stummk/Birdy-Cam/(commit log)

2026-08-10 Add BirdyCam project: docs, firmware & Pi software
    Add the complete BirdyCam project: user docs and full code for both variants. Includes README and detailed docs (01–09), ESP32 firmware (birdycam firmware modules, steps sketches, audio/avi/movement/lighting/network/etc.), Raspberry Pi software (Python service, web UI, ringspeicher, statistik, install script and systemd service), and supporting assets (templates). Implements camera, IR lighting, light‑barrier counting, SD ring buffers, power/INA219 handling, MJPEG/streaming, and audio capture. This is the initial project import with tutorials and install instructions.
2026-08-11 Add audio (clip+stream) and daily CSV archive
    Enable onboard microphone, add audio ring buffer, and include audio in clips and live stream. Rework audio subsystem (ring buffer, voice detection, WAV saving), extend AVI writer to interleave PCM audio, and add web audio endpoint (port 82) and UI controls. Implement hourly/dayly /tage.csv archive with fixed-length lines and /api/tage JSON export; persist daily stats and integrate into storage. Docs updated (hardware, panel guidance, build steps). Other changes: PWM raised to 20 kHz to avoid audio artifacts, power-panel warnings refined, config flags for AUDIO/TAGE options, and multiple firmware integrations (web, avi, audio, speicher, birdycam).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
    [audio.cpp, audio.h, avi.cpp, avi.h, birdycam.ino, config.h, lichtschranke.cpp, speicher.cpp]
2026-09-14 Define built-in LED and improve WiFi setup
    step1: add LED_BUILTIN definition (pin 21) for the board. step3: replace WLAN placeholders with "CHANGEME" and enhance WiFi initialization—perform WiFi.disconnect, set STA mode, lower min security to WPA2 (allows WPA3/WPA2 mixed hotspots), set TX power for XIAO S3, and provide clearer connection status prints. These changes improve portability and reliability when connecting the camera to modern hotspots.
    [step1_hallo.ino, step3_kamera.ino]
2026-09-20 Add audio amplification and sensor debouncing
    Implement audio signal amplification in step6_mikrofon for improved SD card recording and real-time bar display visualization. Add software debouncing in step7_lichtschranke to reduce sensor flickering issues. Include documentation images for settings configuration.
    [step6_mikrofon.ino, step7_lichtschranke.ino]
2026-09-21 Docs: correct MOSFET wiring for the opto-isolated HW-532 module
    Docs: the guide described a 3+4-terminal XY-MOS board, but the part that is
    actually sold is the 23x17 mm HW-532 (AOD4184 + PC817) with 2+3
    terminals: no OUT+, low-side switching, a shared + terminal, a 5 V
    gate-bias caveat and four GND wires instead of three
    Changed: IR dimming runs at 1 kHz instead of 20 kHz, which the PC817
    optocoupler cannot follow
    New: IR_PWM_FREQUENZ in config.h, plus a module self-test with diagnosis
    output in step4_irlicht
    [config.h, step4_irlicht.ino, strom.cpp]
2026-09-21 Docs: replace the JST-PH 2.0 Y-cable with two pigtails and a multimeter test
    JST-PH 2.0 splitters are essentially unobtainable — what is sold as a
    "JST Y-cable" in the RC world is the thicker RCY/BEC connector and does
    not fit the charger's BAT socket. Use two pigtails instead and let the
    sensor's screw terminal act as the junction; both wires per pole go into
    the same clamp.
    Section 3.8 now also answers whether the sensor is needed at all: the
    Waveshare charger protects the cell on its own but has no data output,
    and the XIAO hangs on the regulated 5 V rail, so the state of charge is
    not measurable from there. What the sensor buys is the readout and the
    soft cutoff at 3.40 V instead of t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
2026-09-21 Changed: ship with the light barrier disabled by default
    Changed: LICHTSCHRANKE_AN now defaults to false — the barrier is optional
    accessory, and without a module fitted the image detection counts instead
    Fixed: with the barrier off the website invented a beam state; strahlIstFrei()
    read PIN_LICHTSCHRANKE without a prior pinMode(), and the technical details
    reported a flight count that cannot exist without the module. A new lsAktiv
    flag in the status JSON makes the page say "nicht eingebaut" instead
    Docs: the eight chapters that stated or assumed the old default
    The counting path itself needed no change: lichtschrankeStart() bails out,
    lichtschrankePruefen() guards on aktiv, and birdycam.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
    [config.h, lichtschranke.cpp, lichtschranke.h, web.cpp]
2026-09-21 Docs: screenshots and the working board setting for the Arduino IDE
    Docs: show the IDE main window and the opened Tools menu in section 5.1
    Fixed: XIAO_ESP32S3 leaves the board undetected - select "ESP32S3 Dev Module"
    instead and set PSRAM, flash size and partition scheme by hand
    [birdycam.ino, step1_hallo.ino]
2026-09-21 Fixed: weak WiFi and a far too quiet microphone
    Fixed: step3 throttled the transmitter to 15 dBm ("Drosselung fuer den XIAO
    S3") and set it after WiFi.begin(). Full 19.5 dBm before begin(), and
    modem sleep off, in the sketch and in the firmware
    Fixed: out of the box the ESP32 only knows channels 1-11, so a router on 12
    or 13 stayed invisible - the country code is now DE
    Fixed: step3 waited forever when the router did not answer. It now gives up
    after 20 s and says why
    Fixed: TON_VERSTAERKUNG was 2, far too low for the PDM microphone. Now 16,
    the value validated in sketch 6
    Fixed: step6 amplified the displayed level too, so the number no longer
    matche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
    [birdycam.ino, config.h, netzwerk.cpp, step3_kamera.ino, step6_mikrofon.ino]
2026-09-21 Fixed: the light barrier counted one pass several times
    The debouncing existed only in sketch 7, never in the firmware, where the
    interrupt ran completely unfiltered.
    Fixed: debounce the interrupt (LICHTSCHRANKE_ENTPRELL_MS, 30 ms) and raise
    MIN_UNTERBRECHUNG_MS from 30 to 60 - the simple forked light barriers
    jitter more at the switching point than one expects
    Fixed: if the closing edge fell into the debounce window it was lost, so the
    interruption stayed open forever and the next real pass arrived as an
    absurdly long one. It is discarded once the beam is free again
    New: VOGEL_MAX_DRIN_MINUTEN (12 h) catches a lost exit. Without it a single
    lost edge sw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
    [config.h, lichtschranke.cpp, step7_lichtschranke.ino]
2026-09-21 Docs: build variant B — all electronics inside the box, camera behind the clear lid
    New chapter 4.10 in the build plan: enclosure choice (Hammond 1555FL2GY plus
    the 1554FCL clear lid, 120x90x45 mm), the stacked internal layout with the
    36-of-37-mm height budget, the three cable glands and the six-core control
    cable, the ventilated attic mount, and the OTA/watchdog/reed-reset
    prerequisites that this variant depends on.
    Parts delta as 2.1b in the bill of materials and as 8.4d in the order list,
    including the battery's new maximum dimensions, the dropped 10000 mAh upgrade
    and six extra goods-in checks.
2026-09-25 Docs: series resistors for the IR LEDs, and the MOSFET that ran hot
    Docs: 3.6 gains two sections - why bare LEDs need one resistor each (with the
    calculation, the six terminals and a new wiring diagram from the XIAO pin
    to the last LED), and how to wire a three-pin module such as the KY-005;
    7.3 gains "the MOSFET module gets hot"; 2.2, 4.3 and 8.4d gain the
    matching notes and buying criteria
    Changed: sketch 4 now also reports the hot-module case in its evaluation
2026-10-12 Fixed: the live audio stream never sent a single sample
    Fixed: the stream gated every write on WiFiClient::availableForWrite(), which
    NetworkClient does not override - Print's default returns 0, so the
    gate returned before any PCM data was written and listeners got the WAV
    header and nothing else; the IR flash lit frames that were already
    finished in the camera's buffers instead of the one handed out, so
    night frames stayed dark; camera_config_t went to esp_camera_init()
    uninitialised, leaving sccb_i2c_port and conv_mode as stack garbage; a
    half-open listener socket blocked port 82 until TCP gave up
    New: day and night profile for the sensor -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
2026-10-12 Docs: the corner variant for IR LEDs that stay inside the box
    Docs: new 4.10.9 in the build plan - the black plate with five holes that is
    collar, partition and lens shade in one, and the layout it makes
    possible. Two things unlock it: an FPC extension frees the camera module
    from the XIAO board (32 mm of the 75 mm used, so the ribbon keeps a wide
    bend), and moving the 5000 mAh battery to the middle of the box leaves an
    11 mm margin on each side - just wide enough for a 5 mm LED, which frees
    all four corners of the lid. With the drilling template, the full
    internal layout with positions and heights, and what the corners cost: a
    corner LED sits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
